alexsomesan/CarAudioSteering/README.md

# Car Audio Steering
An microcontroller based adapter for matching steering wheel controls to random car stereo units.
