alexsomesan/CarAudioSteering/STM32Cube/hardware/CarAudioSteering/CarAudioSteering-B_Cu.pdf

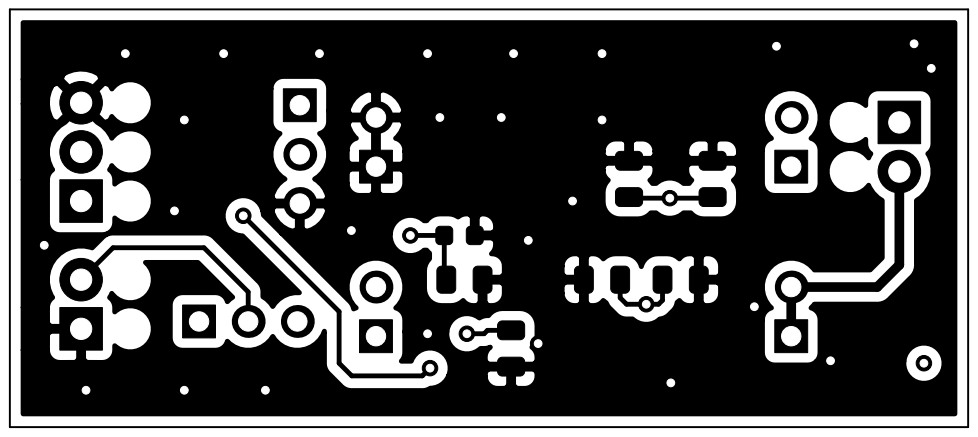
[picture p1: page 1]
