alexsomesan/CarAudioSteering/STM32Cube/hardware/CarAudioSteering/CarAudioSteering-F_Cu.pdf

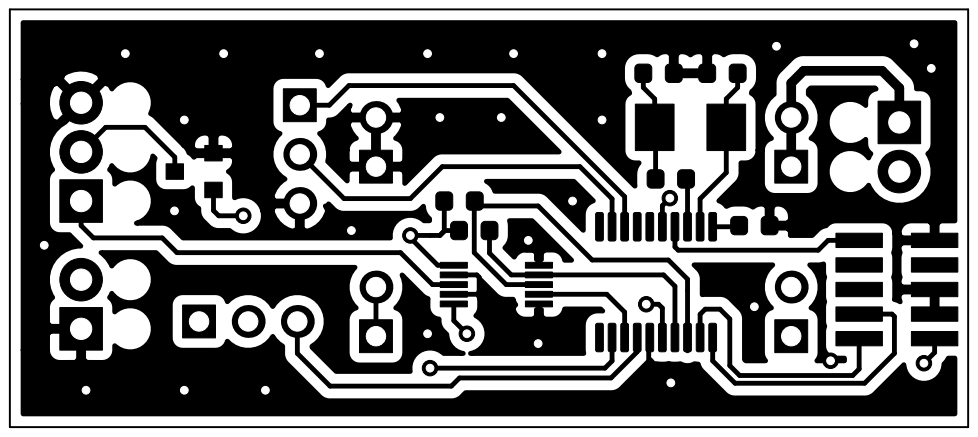
[picture p2: page 1]
