alexsomesan/CarAudioSteering/STM32Cube/hardware/CarAudioSteering/CarAudioSteering.kicad_pcb

## KiCad design STM32Cube/hardware/CarAudioSteering/CarAudioSteering.kicad_pcb (2020-10-22)

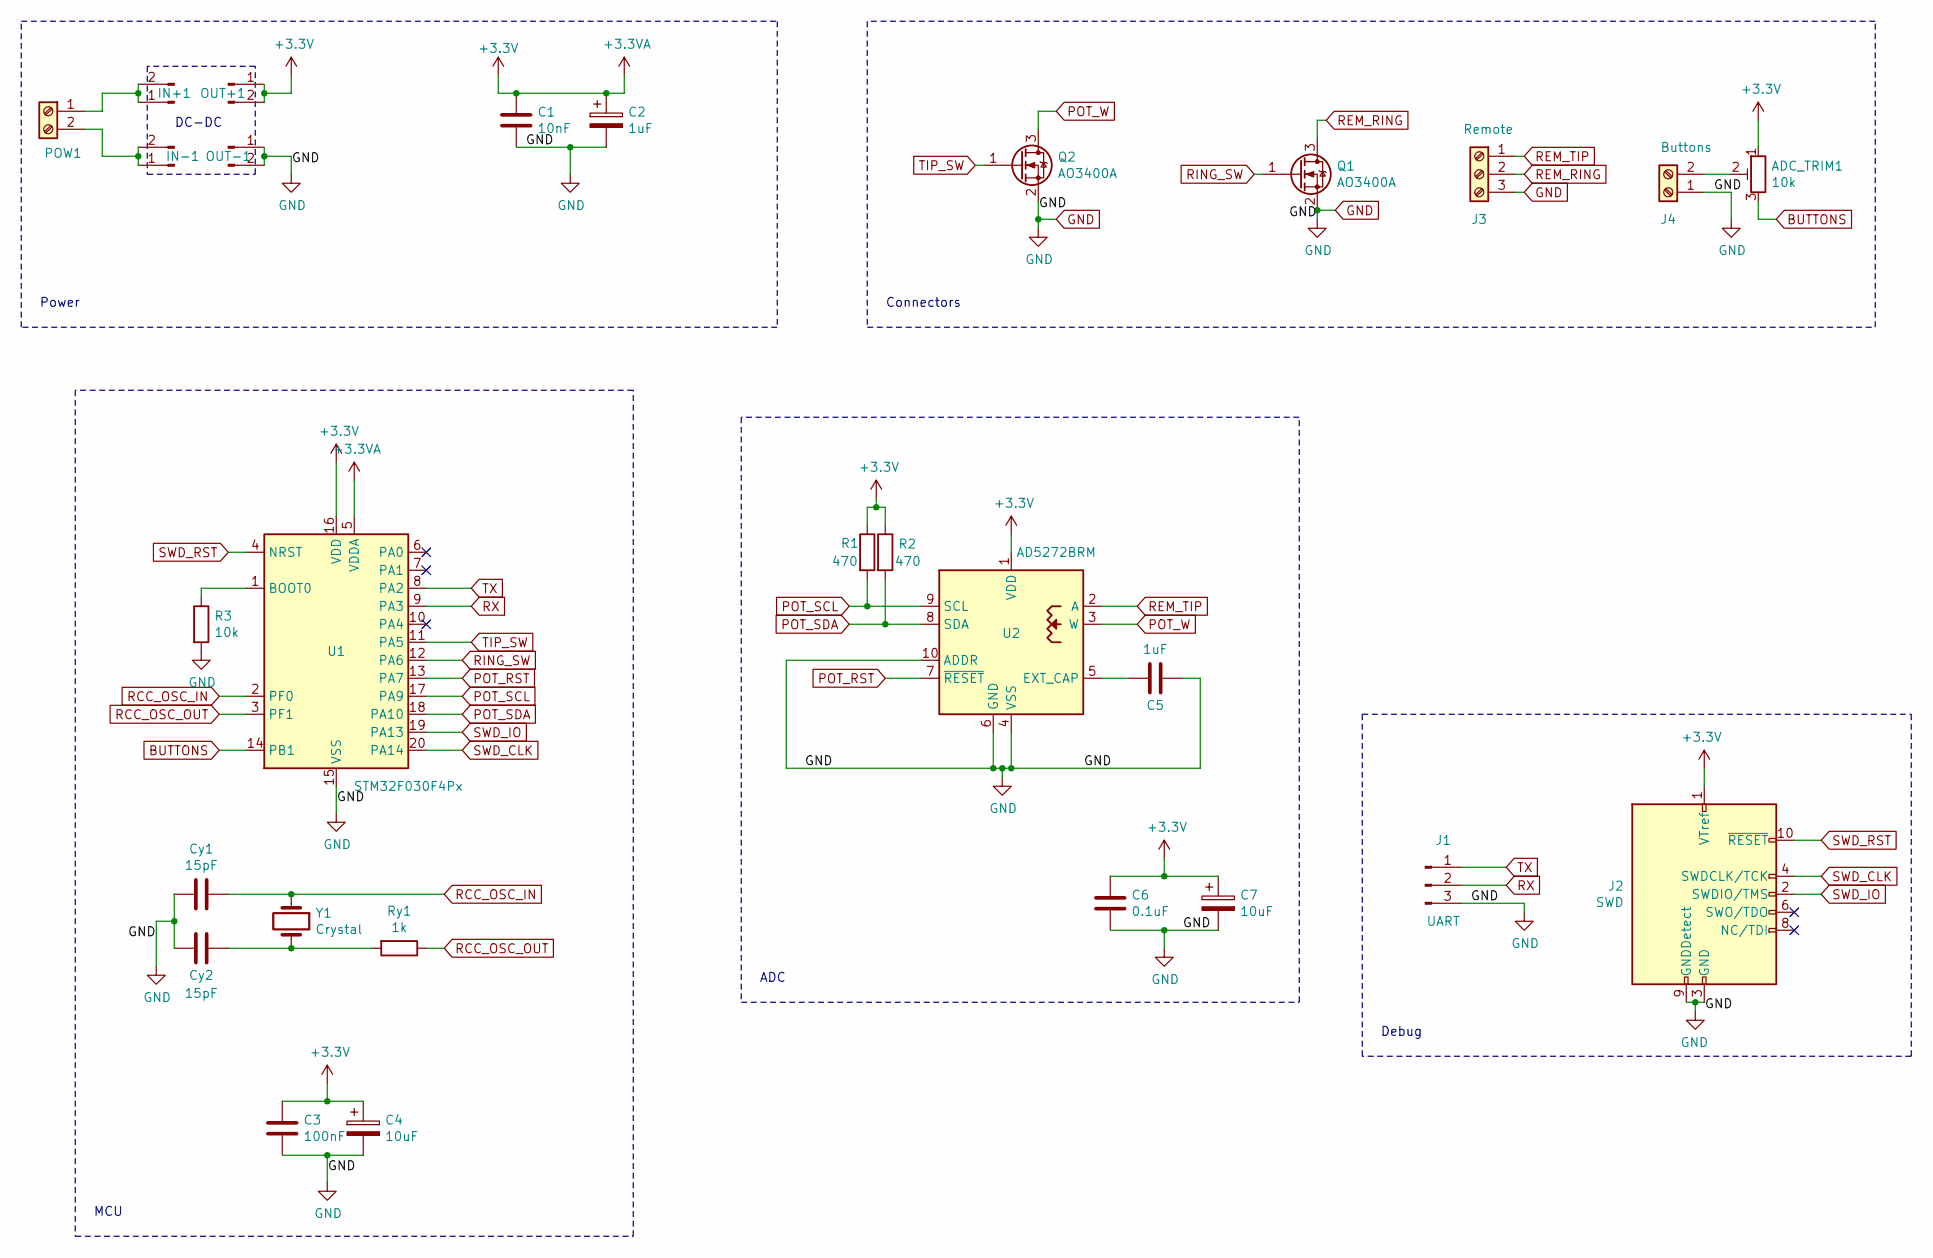
[picture p3: schematic CarAudioSteering.sch]

Parts:
ADC_TRIM1: 10k; PinHeader_1x03_P2.54mm_Vertical
C1: 10nF; C_0805_2012Metric
C2, C5: 1uF; C_0805_2012Metric
C3: 100nF; C_0805_2012Metric
C4, C7: 10uF; C_0805_2012Metric
C6: 0.1uF; C_0603_1608Metric
Cy1, Cy2: 15pF; C_0603_1608Metric
IN+1: Conn_01x02_Male; PinHeader_1x02_P2.54mm_Vertical
IN-1: Conn_01x02_Male; PinHeader_1x02_P2.54mm_Vertical
J1: UART; PinHeader_1x03_P2.54mm_Vertical
J2: SWD; PinHeader_2x05_P1.27mm_Vertical_SMD
J3: Remote; TerminalBlock_Phoenix_MPT-0,5-3-2.54_1x03_P2.54mm_Horizontal
J4: Buttons; TerminalBlock_Phoenix_MPT-0,5-2-2.54_1x02_P2.54mm_Horizontal
OUT+1: Conn_01x02_Male; PinHeader_1x02_P2.54mm_Vertical
OUT-1: Conn_01x02_Male; PinHeader_1x02_P2.54mm_Vertical
POW1: Screw_Terminal_01x02; TerminalBlock_Phoenix_MPT-0,5-2-2.54_1x02_P2.54mm_Horizontal
Q1, Q2: AO3400A; SOT-23
R1, R2: 470; R_0603_1608Metric
R3: 10k; R_0603_1608Metric
Ry1: 1k; R_0603_1608Metric
U1: STM32F030F4Px; TSSOP-20_4.4x6.5mm_P0.65mm
U2: AD5272BRM; MSOP-10_3x3mm_P0.5mm
Y1: Crystal; Crystal_SMD_5032-2Pin_5.0x3.2mm

Connections:
+3.3VA: ADC_TRIM1.1, C1.1, C2.1, C3.1, C4.1, C6.1, C7.1, J2.1 (VTref), OUT+1.1, OUT+1.2, R1.1, R2.1, U1.5 (VDDA), U1.16 (VDD), U2.1 (VDD)
BUTTONS: ADC_TRIM1.3, U1.14 (PB1)
GND: C1.2, C2.2, C3.2, C4.2, C5.1, C6.2, C7.2, Cy1.2, Cy2.1, J1.3, J2.3 (GND), J2.5 (GND), J2.9 (GNDDetect), J3.3, J4.1, OUT-1.1, OUT-1.2, Q1.2 (S), Q2.2 (S), R3.2, U1.15 (VSS), U2.4 (VSS), U2.6 (GND), U2.10 (ADDR)
unnamed: ADC_TRIM1.2, J4.2
unnamed: C5.2, U2.5 (EXT_CAP)
unnamed: Cy2.2, Ry1.2, Y1.2
unnamed: IN+1.1, IN+1.2, POW1.1
unnamed: IN-1.1, IN-1.2, POW1.2
unnamed: R3.1, U1.1 (BOOT0)
POT_RST: U1.13 (PA7), U2.7 (~RESET)
POT_SCL: R1.2, U1.17 (PA9), U2.9 (SCL)
POT_SDA: R2.2, U1.18 (PA10), U2.8 (SDA)
POT_W: Q2.3 (D), U2.3 (W)
RCC_OSC_IN: Cy1.1, U1.2 (PF0), Y1.1
RCC_OSC_OUT: Ry1.1, U1.3 (PF1)
REM_RING: J3.2, Q1.3 (D)
REM_TIP: J3.1, U2.2 (A)
RING_SW: Q1.1 (G), U1.12 (PA6)
RX: J1.2, U1.9 (PA3)
SWD_CLK: J2.4 (SWDCLK/TCK), U1.20 (PA14)
SWD_IO: J2.2 (SWDIO/TMS), U1.19 (PA13)
SWD_RST: J2.10 (~RESET~), U1.4 (NRST)
TIP_SW: Q2.1 (G), U1.11 (PA5)
TX: J1.1, U1.8 (PA2)

Notes on the sheet:
DC-DC
Power
MCU
ADC
Debug
Connectors

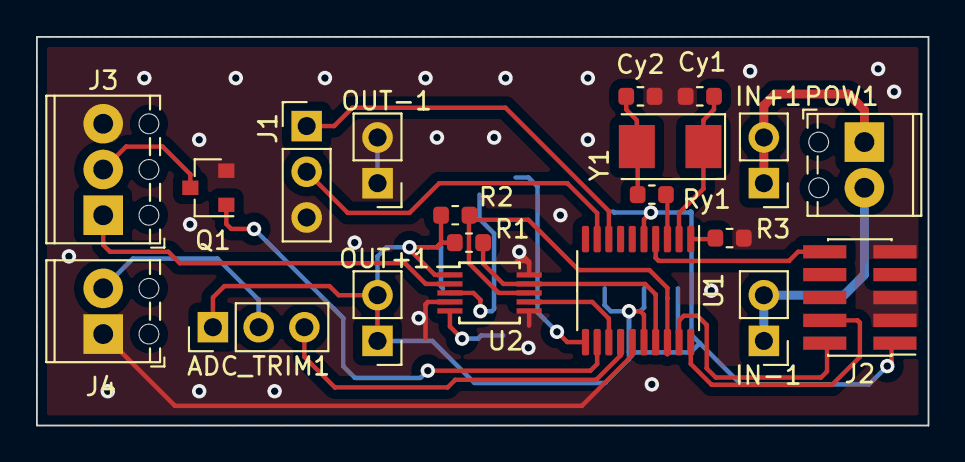
[picture p4: board CarAudioSteering.kicad_pcb from above]

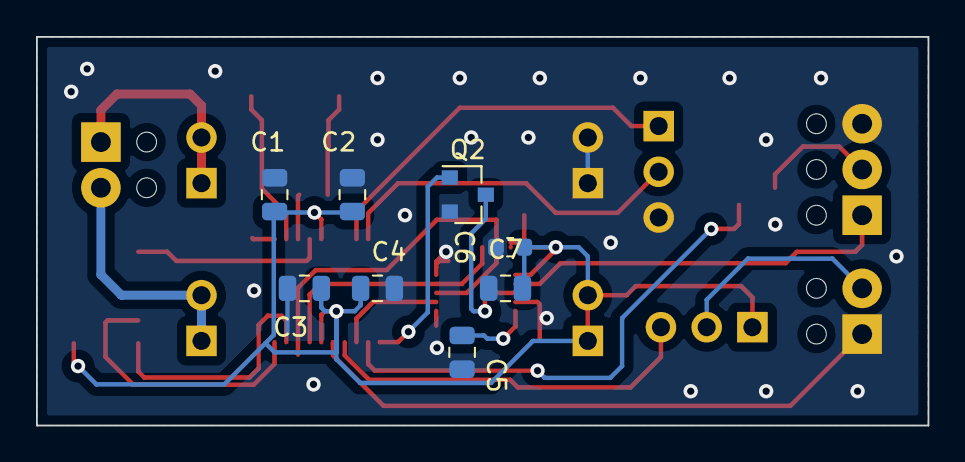
[picture p5: board CarAudioSteering.kicad_pcb from below]

Board: 2 copper layers, 49.5 x 21.6 mm, 28 parts (8 on the bottom side), 24 nets.
