alexsomesan/CarAudioSteering/STM32Cube/Src/main.c

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
/* Includes ------------------------------------------------------------------*/
#include "main.h"
#include "adc.h"
#include "dma.h"
#include "i2c.h"
#include "usart.h"
#include "gpio.h"

/* USER CODE BEGIN Includes */
#include <config.h>
#include "memory.h"
#include "math.h"
#include "ad5272.h"
#include "statemachine.h"
#include "commands.h"

#ifdef FEAT_FLASH_STORAGE
#include "flashstorage.h"
#endif

#ifdef DEBUG
#include "stdio.h"
#include "SEGGER_RTT.h"
#endif

/* USER CODE END Includes */

/* USER CODE BEGIN PM */
#define FL_AVG_READY 0x00000001
#define FL_URX_READY 0x00000002
#define FL_UTX_READY 0x00000004

#define FL_FWD_ADC 0x00000001
#define FL_HANDSHK 0x00000002

/* USER CODE END PM */


/* USER CODE BEGIN PV */
uint16_t readouts[BUT_BUF_LEN];
uint8_t rxBuff[RX_BUF_LEN];
uint8_t txBuff[TX_BUF_LEN];

volatile uint32_t average = 0;
volatile uint32_t intFlags = 0;
volatile uint32_t stateFlags = 0;

/* USER CODE END PV */

void SystemClock_Config(void);
/**
  * @brief  The application entry point.
  * @retval int
  */
int main(void)
{
  /* MCU Configuration--------------------------------------------------------*/

  /* Reset of all peripherals, Initializes the Flash interface and the Systick. */
  HAL_Init();

  /* Configure the system clock */
  SystemClock_Config();

  /* Initialize all configured peripherals */
  MX_GPIO_Init();
  MX_DMA_Init();
  MX_USART1_UART_Init();
  MX_ADC_Init();
  MX_I2C1_Init();
  /* USER CODE BEGIN 2 */
  HAL_GPIO_WritePin(RING_SW_GPIO_Port, RING_SW_Pin, GPIO_PIN_RESET);
  HAL_GPIO_WritePin(TIP_SW_GPIO_Port, TIP_SW_Pin, GPIO_PIN_RESET);

  HAL_ADCEx_Calibration_Start(&hadc);

  ResetAD5272();
  AD5272Addr = scanI2C();

  InitAD5272();

#ifdef DEBUG
  InitCommandNames();
  char avgstr[40];
  sprintf(avgstr, "I2C: %0X\r\n", AD5272Addr);
  SEGGER_RTT_TerminalOut(2, avgstr);
#endif

  HAL_ADC_Start_DMA(&hadc, (uint32_t *)readouts, BUT_BUF_LEN);
  HAL_UART_Receive_DMA(&huart1, rxBuff, RX_BUF_LEN);

  uint32_t avg = 4096;
  /* USER CODE END 2 */

  /* Infinite loop */
  /* USER CODE BEGIN WHILE */
  uint16_t pv;
  while (1)
  {
    // wait for DMA interrupt
    while (0 == (intFlags & FL_AVG_READY))
    {
      if (intFlags & FL_URX_READY)
      {
#ifdef DEBUG
        sprintf(avgstr, "UART: %0X%0X%0X%0 X\r\n", rxBuff[0], rxBuff[1], rxBuff[2], rxBuff[3]);
        SEGGER_RTT_TerminalOut(2, avgstr);
#endif
        switch (rxBuff[0])
        {
        case 0x01: // Manual pot output
          pv = (uint16_t)(rxBuff[2]) << 8 | (uint16_t)(rxBuff[3]);
          if (1 == rxBuff[1])
          {
            HAL_GPIO_WritePin(RING_SW_GPIO_Port, RING_SW_Pin, GPIO_PIN_SET);
          }
          else
          {
            HAL_GPIO_WritePin(RING_SW_GPIO_Port, RING_SW_Pin, GPIO_PIN_RESET);
          }
          if (0x3FF == pv)
          {
            HAL_GPIO_WritePin(TIP_SW_GPIO_Port, TIP_SW_Pin, GPIO_PIN_RESET);
          }
          else
          {
            AD5272_command_write(&hi2c1, AD5272_RDAC_WRITE, pv);
            HAL_GPIO_WritePin(TIP_SW_GPIO_Port, TIP_SW_Pin, GPIO_PIN_SET);
          }
          break;
        case 0x02: // Monitor ADC
          if (rxBuff[1] == 0)
          {
            stateFlags &= ~FL_FWD_ADC;
          }
          else
          {
            stateFlags |= FL_FWD_ADC;
            intFlags |= FL_UTX_READY;
          }
          break;
        case 0xFA: // Host handshake
          if (rxBuff[1] == 0xFB && rxBuff[2] == 0xFC && rxBuff[3] == 0xFD)
          {
#ifdef DEBUG
            SEGGER_RTT_TerminalOut(2, "Got handshake request\r\n");
#endif
            txBuff[0] = 'e';
            txBuff[1] = 'l';
            txBuff[2] = 'l';
            txBuff[3] = 'o';
            intFlags &= ~FL_UTX_READY;
            HAL_UART_Transmit_DMA(&huart1, txBuff, TX_BUF_LEN); // Acknowledge connection
            stateFlags |= FL_HANDSHK;
#ifdef DEBUG
            SEGGER_RTT_TerminalOut(2, "Sent handshake response\r\n");
#endif
          }
          break;
        case 0xFD: // Host disconnect
          if (rxBuff[1] == 0xFC && rxBuff[2] == 0xFB && rxBuff[3] == 0xFA)
          {
            stateFlags &= ~(FL_HANDSHK | FL_FWD_ADC);
          }
          break;
#ifdef FEAT_FLASH_STORAGE
        case 0xE0: // store settings
          if (rxBuff[1] == 0xE1 && rxBuff[2] == 0xE2 && rxBuff[3] == 0xE3)
          {
            storeButtons();
            txBuff[0] = 0xE3;
            txBuff[1] = 0xE2;
            txBuff[2] = 0xE1;
            txBuff[3] = 0xE0;
            intFlags &= ~FL_UTX_READY;
            HAL_UART_Transmit_DMA(&huart1, txBuff, TX_BUF_LEN); // Acknowledge connection
          }
          break;
#endif
        default:
#ifdef DEBUG
          SEGGER_RTT_TerminalOut(2, "Unknown UART command\r\n");
#endif
          break;
        }
        intFlags ^= FL_URX_READY;
      }
    }

    avg = average;
    intFlags &= ~FL_AVG_READY;

    if ((intFlags & FL_UTX_READY) && (stateFlags & FL_FWD_ADC) && (stateFlags & FL_HANDSHK))
    {
      txBuff[0] = 0x02;
      txBuff[1] = (avg >> 8) & 0xFF;
      txBuff[2] = avg & 0xFF;
      txBuff[3] = 0;
      intFlags &= ~FL_UTX_READY;
      HAL_UART_Transmit_DMA(&huart1, txBuff, TX_BUF_LEN);
    }

#ifdef DEBUG
    sprintf(avgstr, "%ld\r\n", avg);
    SEGGER_RTT_TerminalOut(1, avgstr);
#endif
    ProcessInput(avg);

    /* USER CODE END WHILE */

    /* USER CODE BEGIN 3 */
  }
  free(readouts);
  /* USER CODE END 3 */
}

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
/* USER CODE BEGIN 4 */
void HAL_ADC_ConvCpltCallback(ADC_HandleTypeDef *myadc)
{
  for (int i = BUT_BUF_LEN / 2; i < BUT_BUF_LEN; i++)
  {
    average += readouts[i];
  }
  average /= BUT_BUF_LEN / 2;
#if VARIO_FILTER
  uint32_t maxVar = 0;
  for (int i = BUT_BUF_LEN / 2; i < BUT_BUF_LEN; i++)
  {
    uint32_t diff = abs((uint32_t)readouts[i] - average);
    if (diff > maxVar)
    {
      maxVar = diff;
    }
  }
  char maxstr[10];
#ifdef DEBUG
  SEGGER_RTT_TerminalOut(2, strcat(itoa(maxVar, maxstr, 10), "\r\n"));
#endif
  if (maxVar > MAX_VARIATION)
    return;
#endif
  intFlags |= FL_AVG_READY;
}

void HAL_ADC_ConvHalfCpltCallback(ADC_HandleTypeDef *myadc)
{
  for (int i = 0; i < BUT_BUF_LEN / 2; i++)
  {
    average += readouts[i];
  }
  average /= BUT_BUF_LEN / 2;
#if VARIO_FILTER
  uint32_t maxVar = 0;
  for (int i = 0; i < BUT_BUF_LEN / 2; i++)
  {
    uint32_t diff = abs((uint32_t)readouts[i] - average);
    if (diff > maxVar)
    {
      maxVar = diff;
    }
  }
  char maxstr[10];
#ifdef
  SEGGER_RTT_TerminalOut(2, strcat(itoa(maxVar, maxstr, 10), "\r\n"));
#endif
  if (maxVar > MAX_VARIATION)
    return;
#endif
  intFlags |= FL_AVG_READY;
}

void HAL_UART_RxCpltCallback(UART_HandleTypeDef *huart)
{
  intFlags |= FL_URX_READY;
}

void HAL_UART_TxCpltCallback(UART_HandleTypeDef *huart)
{
  intFlags |= FL_UTX_READY;
}

/* USER CODE END 4 */
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
