alexsomesan/CarAudioSteering/STM32Cube/STM32Cube.ioc

Mcu.UserName=STM32F030F4Px
PA10.GPIO_Label=POT_SDA
PA10.Signal=I2C1_SDA
PA13.Signal=SYS_SWDIO
PA14.Signal=SYS_SWCLK
PA2.Signal=USART1_TX
PA3.Signal=USART1_RX
PA5.GPIO_Label=TIP_SW
PA5.Signal=GPIO_Output
PA6.GPIO_Label=RING_SW
PA6.Signal=GPIO_Output
PA7.GPIO_Label=POT_RST
PA7.Signal=GPIO_Output
PA9.GPIO_Label=POT_SCL
PA9.Signal=I2C1_SCL
PB1.GPIO_Label=BUTTONS
PB1.Signal=ADC_IN9
PF0-OSC_IN.Signal=RCC_OSC_IN
PF1-OSC_OUT.Signal=RCC_OSC_OUT
