alexsomesan/CarAudioSteering/HostApp/maindialog.cpp

#include "maindialog.h"
#include "./ui_maindialog.h"
#include <QtSerialPort/QSerialPortInfo>
#include <QtDebug>
#include <QTextStream>

MainDialog::MainDialog(QWidget *parent)
    : QDialog(parent), ui(new Ui::MainDialog), serPort(new QSerialPort), serData(new QByteArray), serReadMux(new QMutex), serportOverride(new QString)
{
    ui->setupUi(this);
    slotDisableUI();
    ui->portComboBox->clear();
    Q_FOREACH (const QSerialPortInfo &pif, QSerialPortInfo::availablePorts())
    {
        ui->portComboBox->addItem(pif.portName());
    }
    ui->speedComboBox->clear();
    QList<qint32> bauds = QSerialPortInfo::standardBaudRates();
    Q_FOREACH (const qint32 &br, bauds)
    {
        ui->speedComboBox->addItem(QString::number(br, 10));
    }
    ui->speedComboBox->setCurrentIndex(bauds.indexOf(115200));
    analogCapture = false;
}

MainDialog::~MainDialog()
{
    delete ui;
}

void MainDialog::slotPortChanged(QString port)
{
    if (serPort->isOpen())
    {
        serPort->close();
        ui->disconnectPushButton->setEnabled(false);
        ui->connectPushButton->setEnabled(true);
    }
    qDebug() << "Changing port to " << port;
    serPort->setPortName(port);
}

void MainDialog::slotConnectSerial()
{
    qint32 bSpeed = ui->speedComboBox->currentText().toInt();
    QString portName = serPort->portName();

    qDebug() << "Connecting to" << portName << "at" << bSpeed << "baudrate...";

    serPort->setBaudRate(bSpeed);

    bool openOK = serPort->isOpen();
    if (!openOK)
    {
        openOK = serPort->open(QIODevice::ReadWrite);
    }

    if (openOK)
    {
        QByteArray payload((int)4, (char)0);
        payload[0] = 0xFA;
        payload[1] = 0xFB;
        payload[2] = 0xFC;
        payload[3] = 0xFD;

        serPort->write(payload);
        serPort->flush();
        qDebug() << "Asking for handshake...";

        bool ack = serPort->waitForReadyRead(2000);
        if (ack)
        {
            QByteArray handshake(5, Qt::Uninitialized);
            handshake.clear();
            handshake.append(serPort->readAll());
            qDebug() << handshake.toHex();
            QString reply = QString(handshake);
            if (reply.contains("ello"))
            {
                qDebug() << "Successful handshake";
                ui->statusLabel->setText(QString("Connected to %1 at %2 baudrate").arg(portName).arg(bSpeed));
                ui->disconnectPushButton->setEnabled(true);
                ui->connectPushButton->setEnabled(false);
                emit deviceConnected();
                connect(serPort, SIGNAL(readyRead()), this, SLOT(slotReadSerial()));
            }
            else
            {
                ui->statusLabel->setText("Failed to connect");
                serPort->clear();
                serPort->reset();
            }
        }
        else
        {
            qDebug() << "Timeout waiting for handshake";
        }
    }
    else
    {
        qDebug() << "Failed to open serial port";
    }
}

void MainDialog::slotDisconnectSerial()
{
    if (serPort->isOpen())
    {
        QByteArray payload((int)4, (char)0);
        payload[0] = 0xFD;
        payload[1] = 0xFC;
        payload[2] = 0xFB;
        payload[3] = 0xFA;
        serPort->write(payload);
        serPort->flush();
        qDebug() << "Asking to disconnect...";
        serPort->close();

        if (analogCapture)
        {
            payload[1] = 0;
            analogCapture = false;
            ui->analogButton->setText("Capture");
            ui->statusLabel->clear();
        }
        ui->disconnectPushButton->setEnabled(false);
        ui->connectPushButton->setEnabled(true);
        ui->statusLabel->setText("Disconnected");
        emit deviceDisconnected();
        disconnect(serPort, SIGNAL(readyRead()), this, SLOT(slotReadSerial()));
    }
}

void MainDialog::slotSetPotValue()
{
    if (serPort->isOpen())
    {
        uint16_t potVal = ui->potValueSlider->value();
        qDebug() << "Setting pot value" << potVal;

        QByteArray payload(4, Qt::Uninitialized);

        payload[0] = 1; // set pot command

        payload[3] = potVal & 0xFF;          // set pot val LSB
        payload[2] = (potVal & 0xFF00) >> 8; // set pot val MSB

        if (ui->ringCheckBox->checkState() == Qt::Checked)
        {
            payload[1] = 1; // set ring off
        }
        else
        {
            payload[1] = 0; // set ring on
        }

        serPort->write(payload);
        serPort->flush();
        qDebug() << "Sent command:" << Qt::hex << (uint8_t)(payload[0]) << "|" << (uint8_t)(payload[1]) << "|" << (uint8_t)(payload[2]) << (uint8_t)(payload[3]);
    }
}

void MainDialog::slotClearPotValue()
{
    if (serPort->isOpen())
    {
        qDebug() << "Clearing pot value";

        QByteArray payload(4, Qt::Uninitialized);

        payload[0] = 1;    // set pot command
        payload[1] = 0;    // set ring off
        payload[2] = 0x03; // set pot val MSB
        payload[3] = 0xFF; // set pot val LSB

        serPort->write(payload);
        serPort->flush();
        qDebug() << "Sent command:" << Qt::hex << (uint8_t)(payload[0]) << "|" << (uint8_t)(payload[1]) << "|" << (uint8_t)(payload[2]) << (uint8_t)(payload[3]);
    }
}

void MainDialog::slotCaptureAnalog()
{
    QByteArray payload(4, Qt::Uninitialized);

    payload[0] = 0x02; // set adc command
    payload[2] = 0x00; // padding
    payload[3] = 0x00; // padding

    if (analogCapture)
    {
        payload[1] = 0;
        analogCapture = false;
        ui->analogButton->setText("Capture");
        ui->statusLabel->clear();
    }
    else
    {
        payload[1] = 1;
        analogCapture = true;
        ui->analogButton->setText("Stop");
    }

    serPort->write(payload);
    serPort->flush();
}

void MainDialog::slotReadSerial()
{
    QMutexLocker locker(serReadMux);
    QString qs;
    uint16_t adcVal;

    serData->clear();
    serData->append(serPort->readAll());

    switch ((uint8_t)(serData->at(0)))
    {
    case 0x02:
        adcVal = (uint8_t)(serData->at(1)) << 8 | (uint8_t)(serData->at(2));

        if (ui->adcBar->maximum() < adcVal)
        {
            ui->adcBar->setMaximum(adcVal);
        }
        ui->adcBar->setValue(adcVal);
        qs = QString::number(adcVal);
        ui->adcVal->display(qs);
        ui->statusLabel->setText(qs);
        break;
    case 0xE3:
        if (
            0xE2 == (uint8_t)((*serData)[1]) &&
            0xE1 == (uint8_t)((*serData)[2]) &&
            0xE0 == (uint8_t)((*serData)[3]))
        {
            ui->statusLabel->setText("Save acknoledged...");
        }
        else
        {
            ui->statusLabel->setText("Save not acknoledged...");
        }
        break;
    }
}

void MainDialog::slotEnableUI()
{
    ui->analogValueBox->setEnabled(true);
    ui->potValueBox->setEnabled(true);
    ui->programmBox->setEnabled(true);
}

void MainDialog::slotDisableUI()
{
    ui->analogValueBox->setEnabled(false);
    ui->potValueBox->setEnabled(false);
    ui->programmBox->setEnabled(false);
}

void MainDialog::setPortOverride(QString p)
{
    *serportOverride = p;
    ui->portComboBox->addItem(p);
    ui->portComboBox->setCurrentText(p);
}

void MainDialog::slotSaveValues()
{
    if (serPort->isOpen())
    {
        QByteArray payload((int)4, Qt::Uninitialized);
        payload[0] = 0xE0;
        payload[1] = 0xE1;
        payload[2] = 0xE2;
        payload[3] = 0xE3;
        serPort->write(payload);
        serPort->flush();
        qDebug() << "Asking to save values...";
        ui->statusLabel->setText("Save requested...");
    }
}
