alexsomesan/CarAudioSteering/STM32Cube/Inc/main.h

#define TIP_SW_Pin GPIO_PIN_5
#define TIP_SW_GPIO_Port GPIOA
#define RING_SW_Pin GPIO_PIN_6
#define RING_SW_GPIO_Port GPIOA
#define POT_RST_Pin GPIO_PIN_7
#define POT_RST_GPIO_Port GPIOA
#define BUTTONS_Pin GPIO_PIN_1
#define BUTTONS_GPIO_Port GPIOB
#define POT_SCL_Pin GPIO_PIN_9
#define POT_SCL_GPIO_Port GPIOA
#define POT_SDA_Pin GPIO_PIN_10
#define POT_SDA_GPIO_Port GPIOA
