alexsomesan/CarAudioSteering/STM32Cube/Inc/config.h

#ifndef __CONFIG_H
#define __CONFIG_H

#define BUT_BUF_LEN 512
#define RX_BUF_LEN 4
#define TX_BUF_LEN 4
#define VARIO_FILTER 0
#define MAX_VARIATION 6
#define TOLERANCE 20

// Store settings in flash
// #define FEAT_FLASH_STORAGE
// #define FEAT_FLASH_STORAGE_ERASE

#endif
