alexsomesan/CarAudioSteering/(commit log)

2019-02-03 WIP Prototype - basic commands
2019-02-05 Switch to FastADC for reading inputs. Adapt welcome message prompt.
2019-02-06 Small fixes. Make FastADC optional for now. Add test-platform input values.
    [config.h]
2020-10-22 Re-implementation with STM32F0 + a first PCB draft (#1)
    STM32Cube version
    [CarAudioSteering.kicad_pcb, CarAudioSteering.sch]
2020-10-22 Remove unmaintained Arduino version
2020-10-22 Update PCB to add a MOSFET switch on the digipot output
    [CarAudioSteering.kicad_pcb, CarAudioSteering.sch]
2020-10-30 Fix build issue with Qt signals
    [maindialog.h]
2020-10-30 Implement MOS gateway on TIP pin
2020-10-30 Fix build after rebase
    [commands.c, main.c]
2021-09-02 Consolidate handshake and fix digipot initialization
    [STM32Cube.ioc, ad5272.c, ad5272.h, commands.c]
2021-09-03 Fix command output routines
    [commands.c]
